hanyazou/RP2350B-DIP40/schematic.pdf

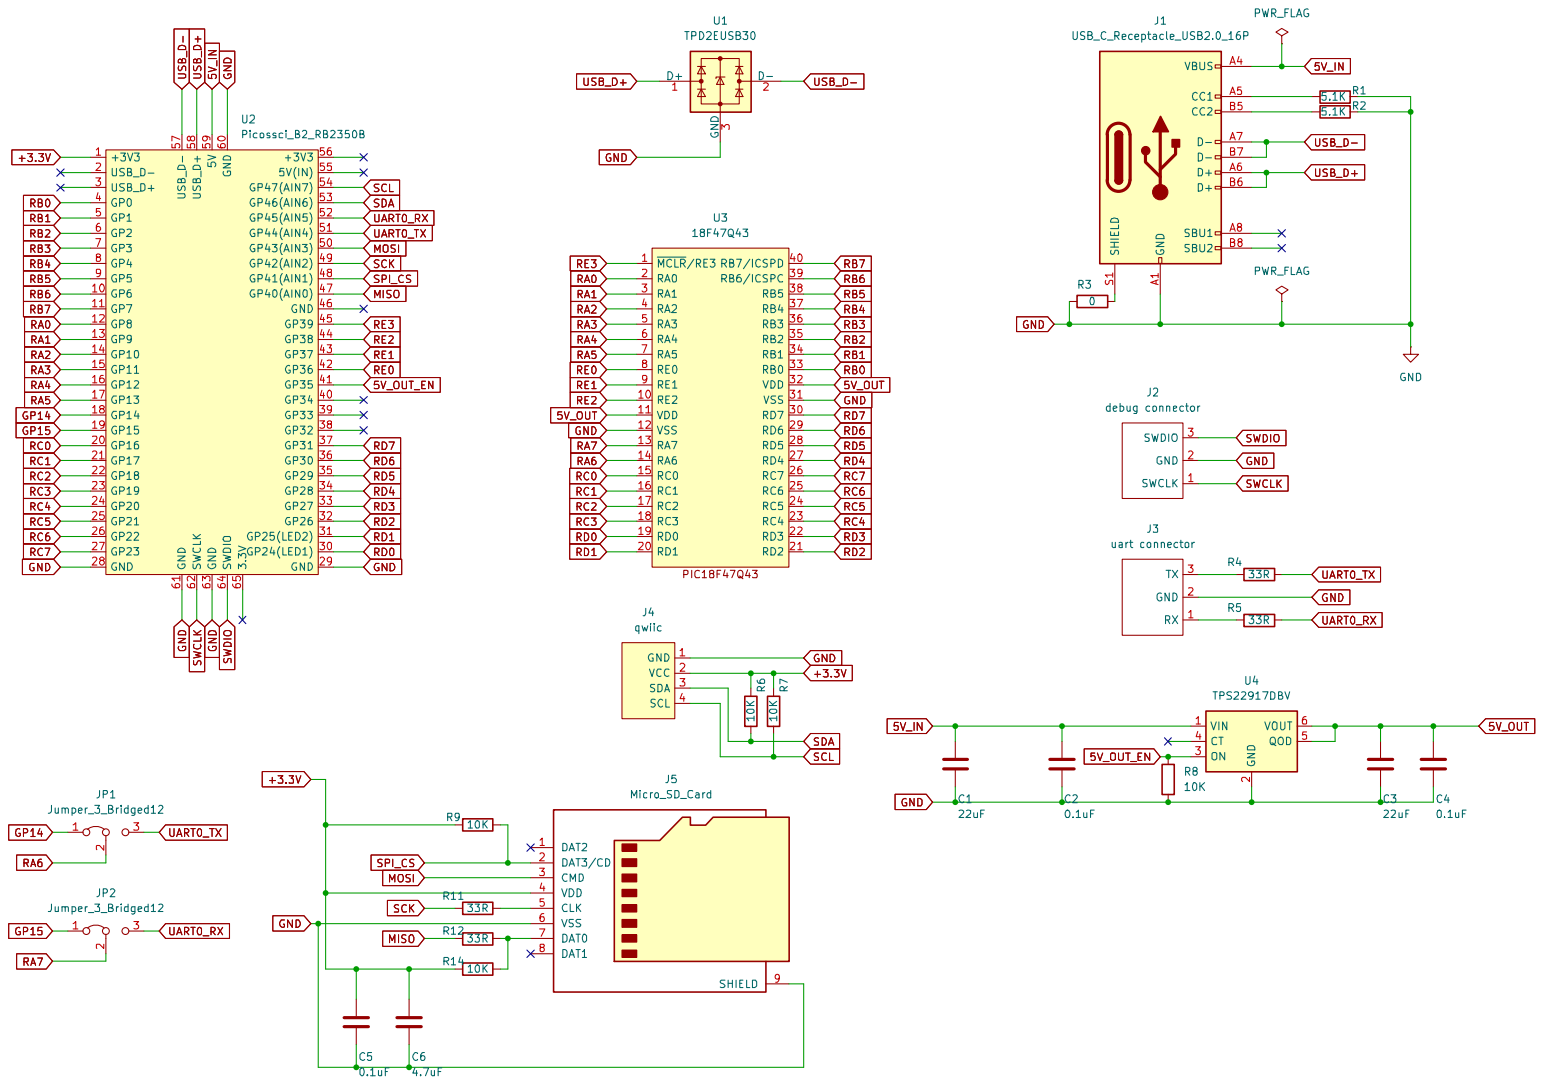
[picture p1: page 1]
