hanyazou/RP2350B-DIP40/kicad/RP2350B-DIP40.kicad_pcb

## KiCad design kicad/RP2350B-DIP40.kicad_pcb (2026-04-18)

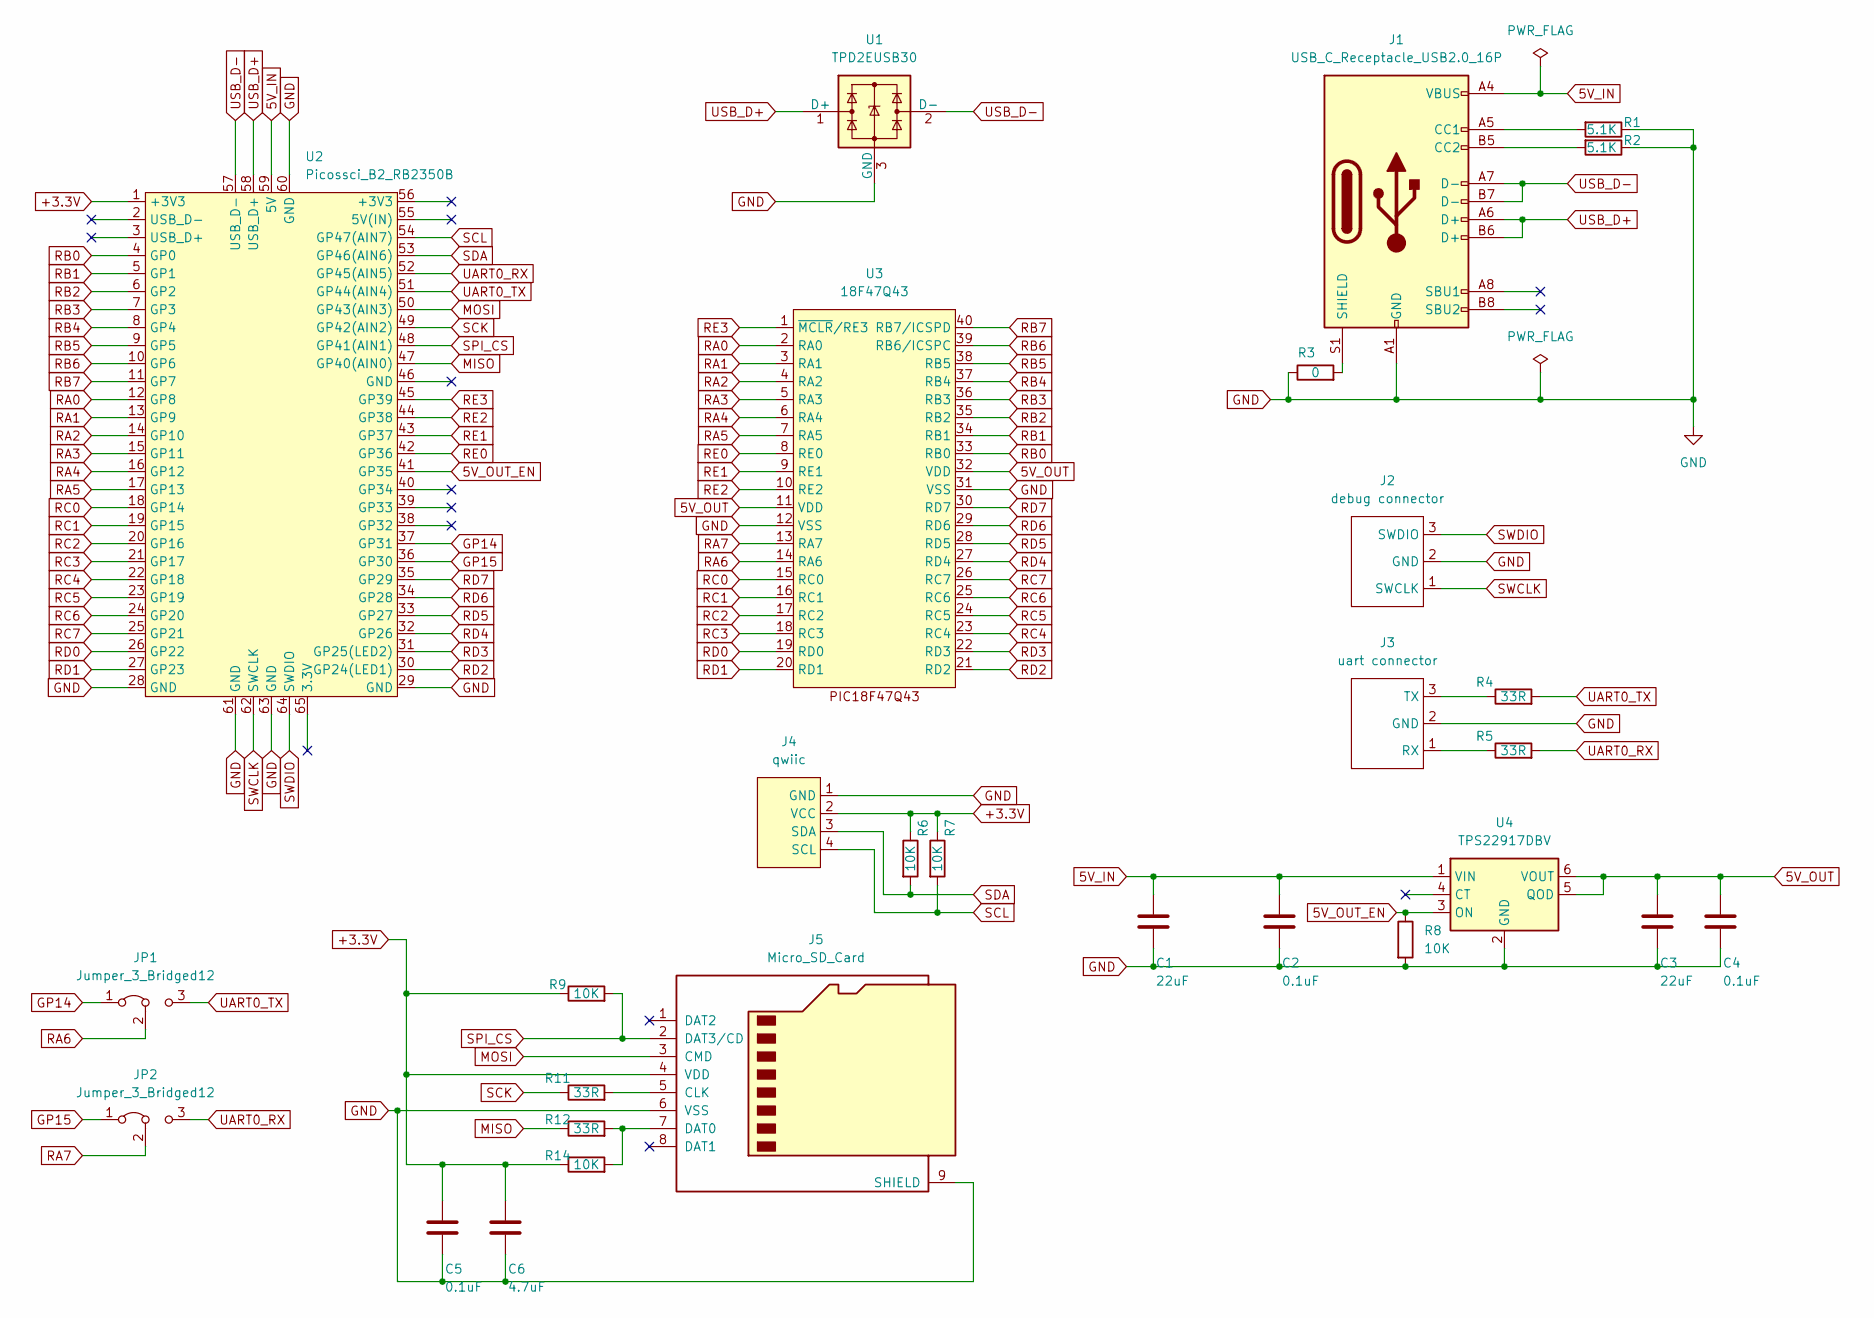
[picture p2: schematic RP2350B-DIP40.kicad_sch]

Parts:
C1, C3: 22uF; C_0805_2012Metric_Pad1.18x1.45mm_HandSolder
C2, C4, C5: 0.1uF; C_0603_1608Metric_Pad1.08x0.95mm_HandSolder
C6: 4.7uF; C_0603_1608Metric_Pad1.08x0.95mm_HandSolder
J1: USB_C_Receptacle_USB2.0_16P; USB_C_Receptacle_Neltron_5077CR-16SMC2
J2: debug connector; JST_SH_SM03B-SRSS-TB_1x03-1MP_P1.00mm_Horizontal
J3: uart connector; JST_SH_SM03B-SRSS-TB_1x03-1MP_P1.00mm_Horizontal
J4: qwiic; JST_SH_SM04B-SRSS-TB_1x04-1MP_P1.00mm_Horizontal
J5: Micro_SD_Card; microSD_HC_Hirose_DM3AT-SF-PEJM5
JP1, JP2: Jumper_3_Bridged12; SolderJumper-3_P1.3mm_Bridged12_RoundedPad1.0x1.5mm_NumberL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
R1, R2: 5.1K; R_0603_1608Metric_Pad0.98x0.95mm_HandSolder
R3: 0; R_0603_1608Metric_Pad0.98x0.95mm_HandSolder
R4, R5, R11, R12: 33R; R_0603_1608Metric_Pad0.98x0.95mm_HandSolder
R6, R7, R8, R9, R14: 10K; R_0603_1608Metric_Pad0.98x0.95mm_HandSolder
U1: TPD2EUSB30; Texas_DRT-3
U2: Picossci_B2_RB2350B; Picossci_2B_RP2350B
U3: 18F47Q43; Pin_Header-2x20_SMD
U4: TPS22917DBV; SOT-23-6

Connections:
5V_IN: C1.1, C2.1, J1.A4 (VBUS), J1.A9 (VBUS), J1.B4 (VBUS), J1.B9 (VBUS), U2.59 (5V), U4.1 (VIN)
5V_OUT: C3.1, C4.1, U3.11 (VDD), U3.32 (VDD), U4.5 (QOD), U4.6 (VOUT)
5V_OUT_EN: R8.1, U2.41 (GP35), U4.3 (ON)
+3.3V: C5.1, C6.1, J4.2 (VCC), J5.4 (VDD), R6.1, R7.1, R9.1, R14.1, U2.1 (+3V3)
GND: C1.2, C2.2, C3.2, C4.2, C5.2, C6.2, J1.A1 (GND), J1.A12 (GND), J1.B1 (GND), J1.B12 (GND), J2.2 (GND), J3.2 (GND), J4.1 (GND), J5.6 (VSS), J5.9 (SHIELD), R1.1, R2.1, R3.1, R8.2, U1.3 (GND), U2.28 (GND), U2.29 (GND), U2.60 (GND), U2.61 (GND), U2.63 (GND), U3.12 (VSS), U3.31 (VSS), U4.2 (GND)
GP14: JP1.1 (A), U2.37 (GP31)
GP15: JP2.1 (A), U2.36 (GP30)
MISO: R12.1, U2.47 (GP40(AIN0))
MOSI: J5.3 (CMD), U2.50 (GP43(AIN3))
unnamed: J1.A5 (CC1), R1.2
unnamed: J1.B5 (CC2), R2.2
unnamed: J1.S1 (SHIELD), R3.2
unnamed: J3.1 (RX), R5.1
unnamed: J3.3 (TX), R4.1
unnamed: J5.5 (CLK), R11.2
unnamed: J5.7 (DAT0), R12.2, R14.2
RA0: U2.12 (GP8), U3.2 (RA0)
RA1: U2.13 (GP9), U3.3 (RA1)
RA2: U2.14 (GP10), U3.4 (RA2)
RA3: U2.15 (GP11), U3.5 (RA3)
RA4: U2.16 (GP12), U3.6 (RA4)
RA5: U2.17 (GP13), U3.7 (RA5)
RA6: JP1.2 (C), U3.14 (RA6)
RA7: JP2.2 (C), U3.13 (RA7)
RB0: U2.4 (GP0), U3.33 (RB0)
RB1: U2.5 (GP1), U3.34 (RB1)
RB2: U2.6 (GP2), U3.35 (RB2)
RB3: U2.7 (GP3), U3.36 (RB3)
RB4: U2.8 (GP4), U3.37 (RB4)
RB5: U2.9 (GP5), U3.38 (RB5)
RB6: U2.10 (GP6), U3.39 (RB6/ICSPC)
RB7: U2.11 (GP7), U3.40 (RB7/ICSPD)
RC0: U2.18 (GP14), U3.15 (RC0)
RC1: U2.19 (GP15), U3.16 (RC1)
RC2: U2.20 (GP16), U3.17 (RC2)
RC3: U2.21 (GP17), U3.18 (RC3)
RC4: U2.22 (GP18), U3.23 (RC4)
RC5: U2.23 (GP19), U3.24 (RC5)
RC6: U2.24 (GP20), U3.25 (RC6)
RC7: U2.25 (GP21), U3.26 (RC7)
RD0: U2.26 (GP22), U3.19 (RD0)
RD1: U2.27 (GP23), U3.20 (RD1)
RD2: U2.30 (GP24(LED1)), U3.21 (RD2)
RD3: U2.31 (GP25(LED2)), U3.22 (RD3)
RD4: U2.32 (GP26), U3.27 (RD4)
RD5: U2.33 (GP27), U3.28 (RD5)
RD6: U2.34 (GP28), U3.29 (RD6)
RD7: U2.35 (GP29), U3.30 (RD7)
RE0: U2.42 (GP36), U3.8 (RE0)
RE1: U2.43 (GP37), U3.9 (RE1)
RE2: U2.44 (GP38), U3.10 (RE2)
RE3: U2.45 (GP39), U3.1 (~MCLR/RE3)
SCK: R11.1, U2.49 (GP42(AIN2))
SCL: J4.4 (SCL), R7.2, U2.54 (GP47(AIN7))
SDA: J4.3 (SDA), R6.2, U2.53 (GP46(AIN6))
SPI_CS: J5.2 (DAT3/CD), R9.2, U2.48 (GP41(AIN1))
SWCLK: J2.1 (SWCLK), U2.62 (SWCLK)
SWDIO: J2.3 (SWDIO), U2.64 (SWDIO)
UART0_RX: JP2.3 (B), R5.2, U2.52 (GP45(AIN5))
UART0_TX: JP1.3 (B), R4.2, U2.51 (GP44(AIN4))
USB_D+: J1.A6 (D+), J1.B6 (D+), U1.1 (D+), U2.58 (USB_D+)
USB_D-: J1.A7 (D-), J1.B7 (D-), U1.2 (D-), U2.57 (USB_D-)

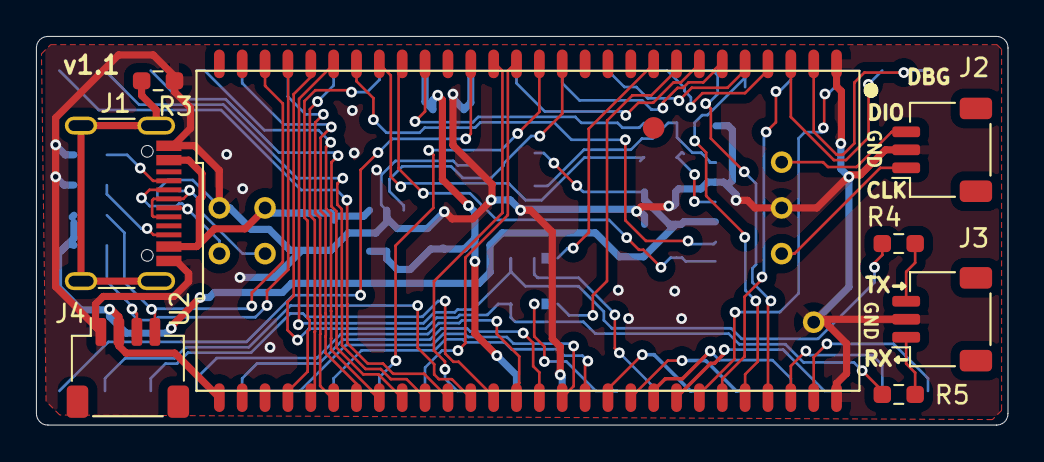
[picture p3: board RP2350B-DIP40.kicad_pcb from above]

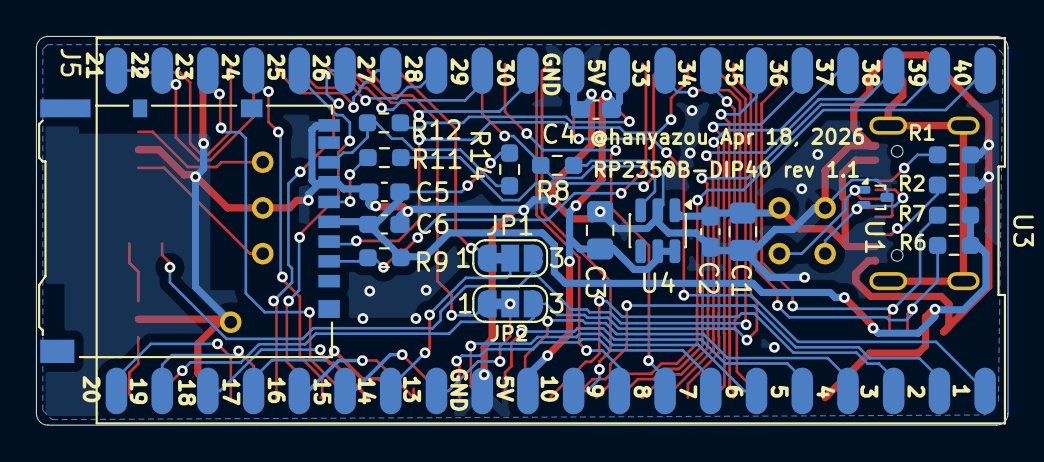
[picture p4: board RP2350B-DIP40.kicad_pcb from below]

Board: 2 copper layers, 54.0 x 21.6 mm, 29 parts (20 on the bottom side), 62 nets.
