hanyazou/RP2350B-DIP40/(commit log)

2026-03-08 Add PCB design RP2350B-DIP40-rev0.8
    [RP2350B-DIP40.kicad_pcb, RP2350B-DIP40.kicad_sch]
2026-03-08 Add schematic.pdf
2026-03-22 Add PCB design RP2350B-DIP40-rev1.0
    [RP2350B-DIP40.kicad_pcb, RP2350B-DIP40.kicad_sch]
2026-04-18 Add PCB design RP2350B-DIP40-rev1.1
    [RP2350B-DIP40.kicad_pcb, RP2350B-DIP40.kicad_sch]
2026-05-02 Fix pins test for PCB rev1.1
    [pins.c]
